benthacher/growth_module_pcb/3d/RNP0030B.stp

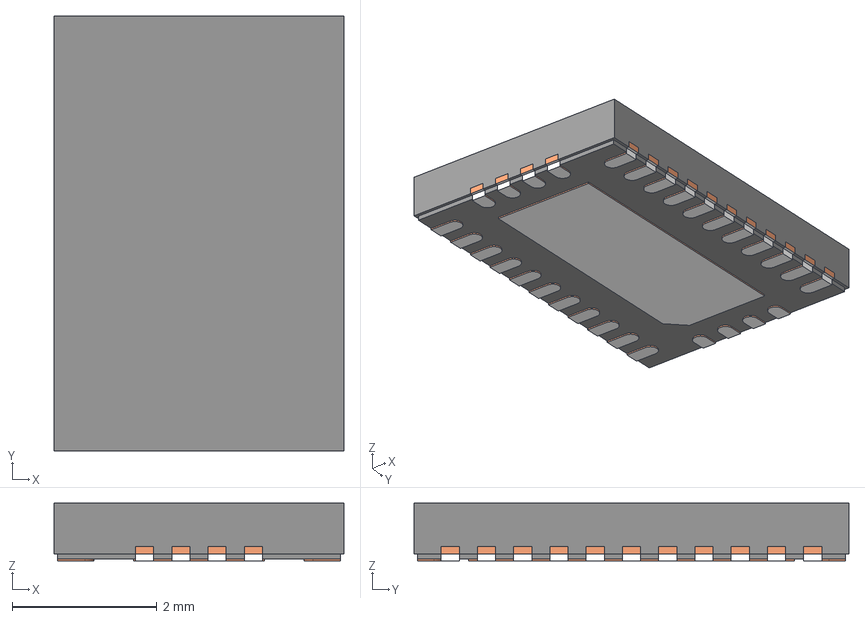
[picture p1: CAD file, 2024-05-28]
3d/RNP0030B.stp
4.00 x 6.00 x 0.8 mm
BODY-QFN_AF0
FRAME-RNP0030B_AF0
PIN1-ID
