benthacher/growth_module_pcb/growth_module_pcb.step

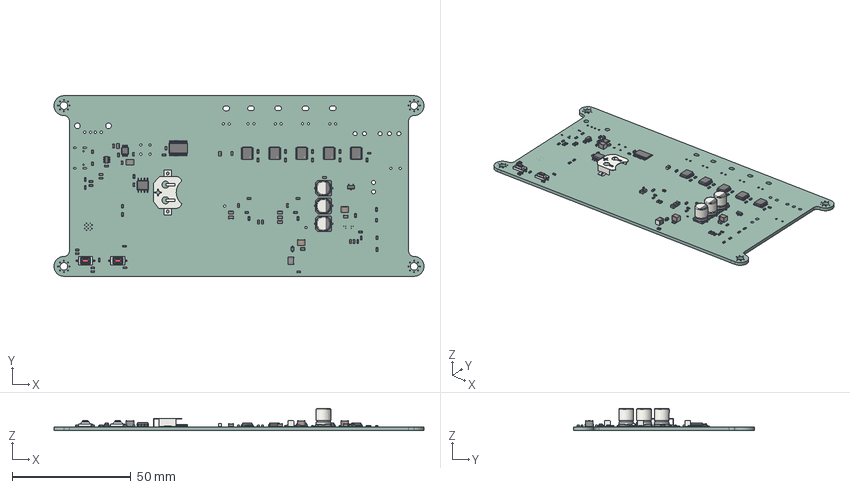
[picture p2: CAD file, 2024-05-28]
growth_module_pcb.step
156.1 x 76.2 x 9.35 mm
C_0603_1608Metric x 25
TSSOP_24_44x78mm_P065mm
C_0805_2012Metric x 8
R_0603_1608Metric x 34
L_1210_3225Metric x 2
TSSOP_16_1EP_44x5mm_Pitch065mm_EP34x5mm x 5
D_SOD_323
SOT_23_6
R_0805_2012Metric
C_1210_3225Metric x 2
CP_Elec_63x77 x 3
Keystone_3000_1x12mm
SW_SPST_CK_RS282G05A3 x 2
SOT_23
MSOP_10_3x3mm_P05mm
SOIC_8_39x49mm_P127mm
_autosave-growth_module_pcb_PCB
