benthacher/growth_module_pcb/3d/IND_BOURNS_SRP1270.step

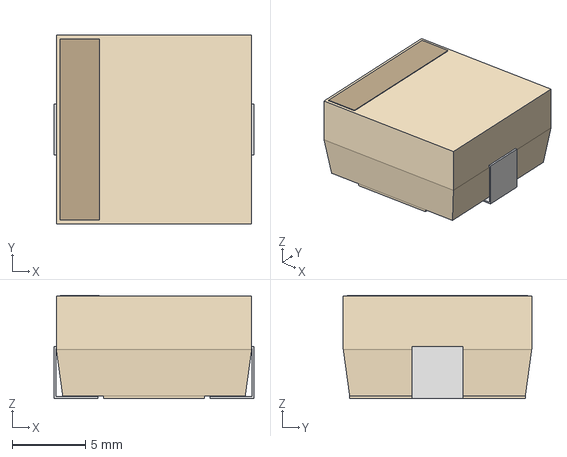
[picture p3: CAD file, 2024-05-28]
3d/IND_BOURNS_SRP1270.step
13.7 x 12.9 x 7.06 mm
