benthacher/growth_module_pcb/3d/TPS1HB50AQPWPRQ1.stp

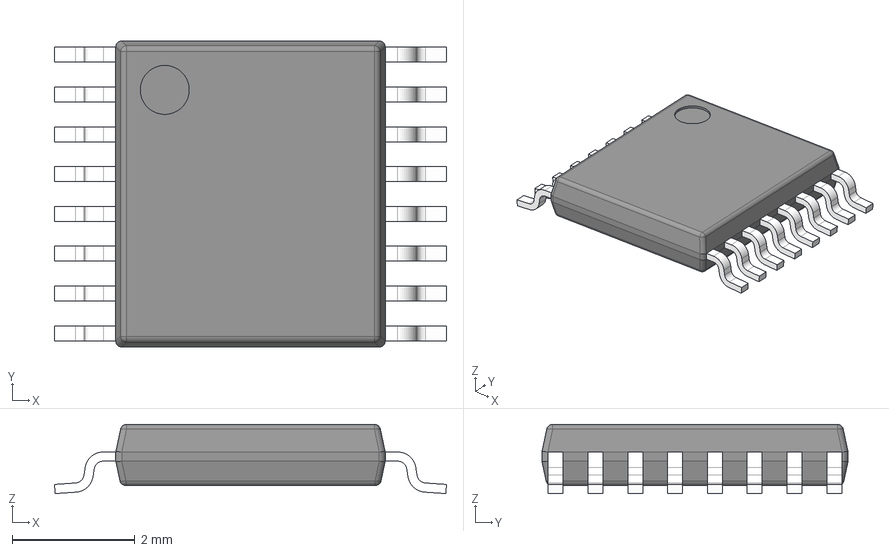
[picture p4: CAD file, 2024-05-28]
3d/TPS1HB50AQPWPRQ1.stp
6.40 x 5.00 x 1.13 mm
BODY-TSSOP
LEAD-TSSOP x 16
PIN1
DAP
