benthacher/growth_module_pcb/3d/SDR1006-220ML.stp

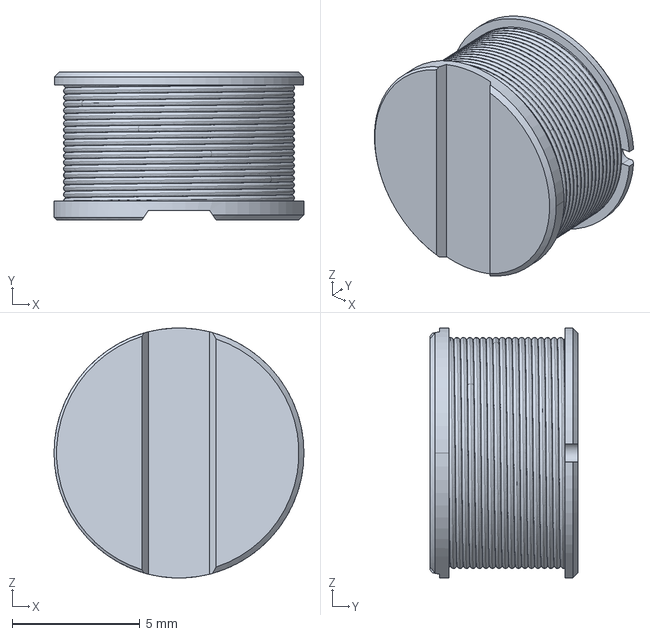
[picture p5: CAD file, 2024-05-28]
3d/SDR1006-220ML.stp
9.80 x 5.80 x 9.80 mm
