benthacher/growth_module_pcb/3d/ESP32-S3-WROOM-1-N8R8.step

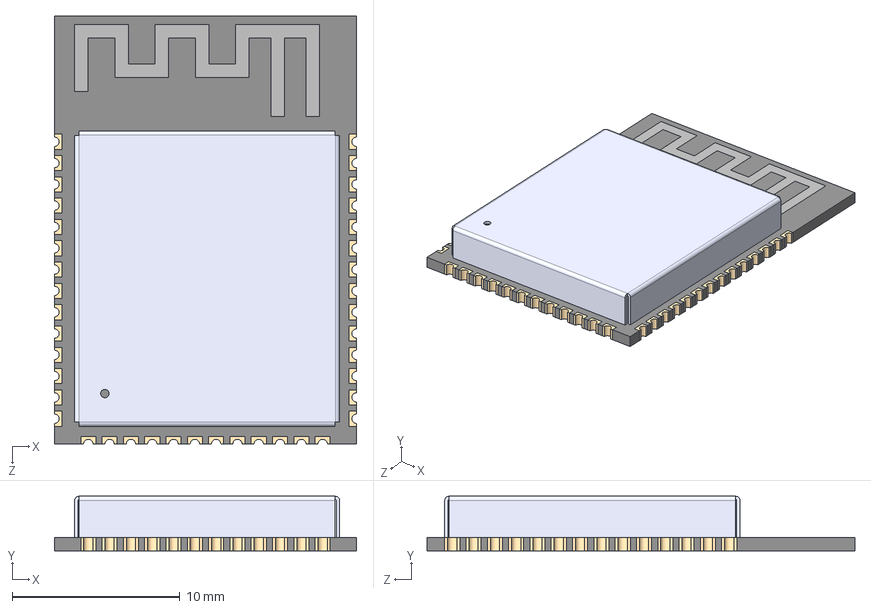
[picture p6: CAD file, 2024-05-28]
3d/ESP32-S3-WROOM-1-N8R8.step
18.0 x 3.25 x 25.5 mm
