benthacher/growth_module_pcb/3d/UE27AC54100.step

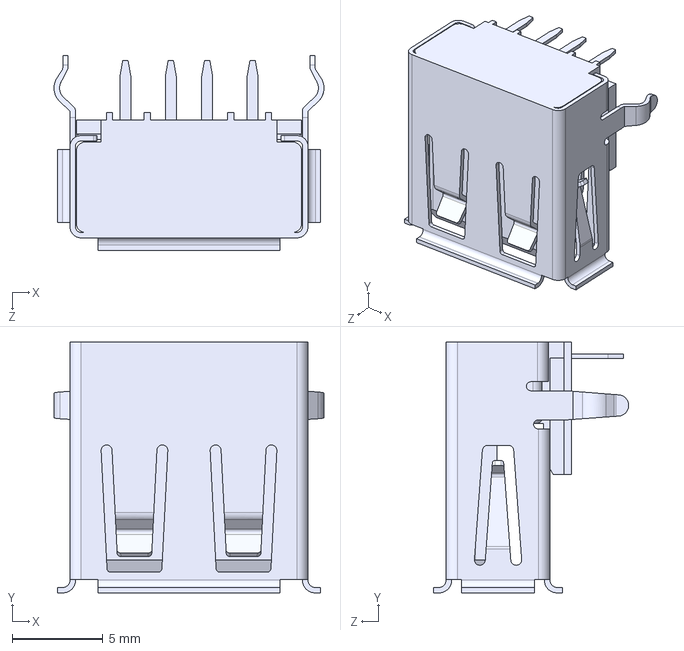
[picture p7: CAD file, 2024-05-28]
3d/UE27AC54100.step
14.9 x 13.8 x 10.7 mm
