benthacher/growth_module_pcb/3d/2-84952-0.stp

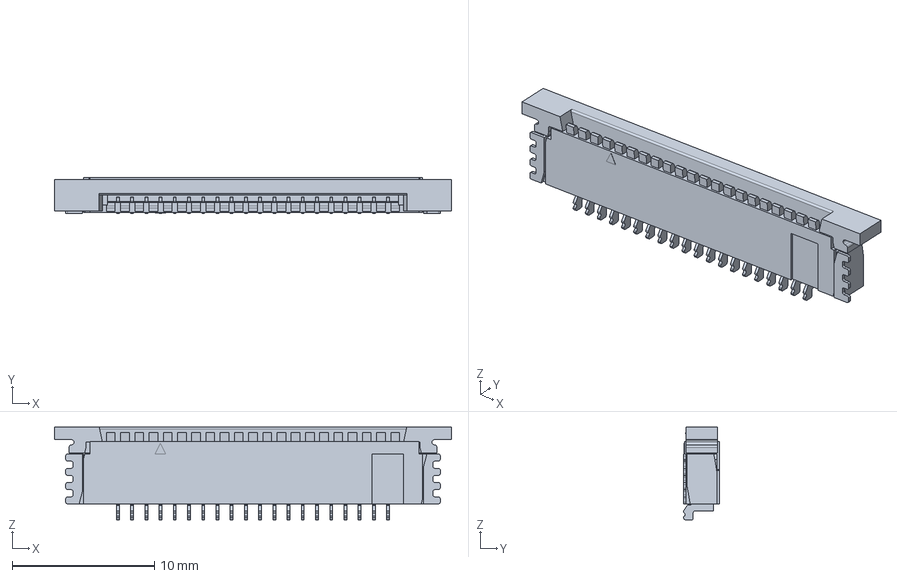
[picture p8: CAD file, 2024-05-28]
3d/2-84952-0.stp
27.9 x 2.56 x 6.54 mm
