benthacher/growth_module_pcb/3d/SFW16R-1STE1LF.step

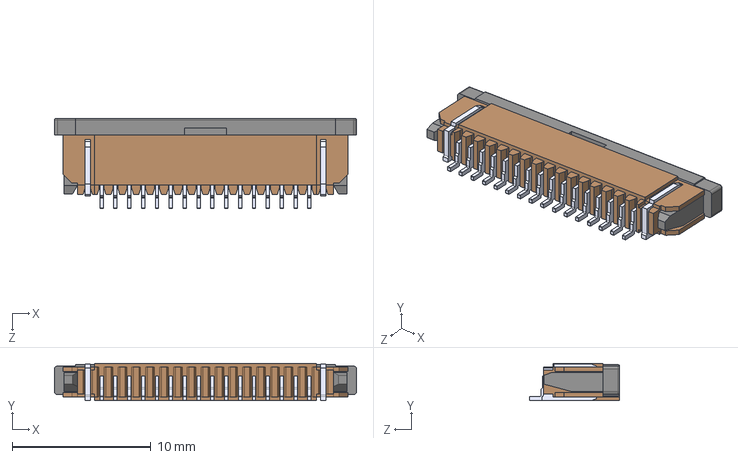
[picture p9: CAD file, 2024-05-28]
3d/SFW16R-1STE1LF.step
21.8 x 2.70 x 6.50 mm
