benthacher/growth_module_pcb/3d/TUSB1106RGTR.step

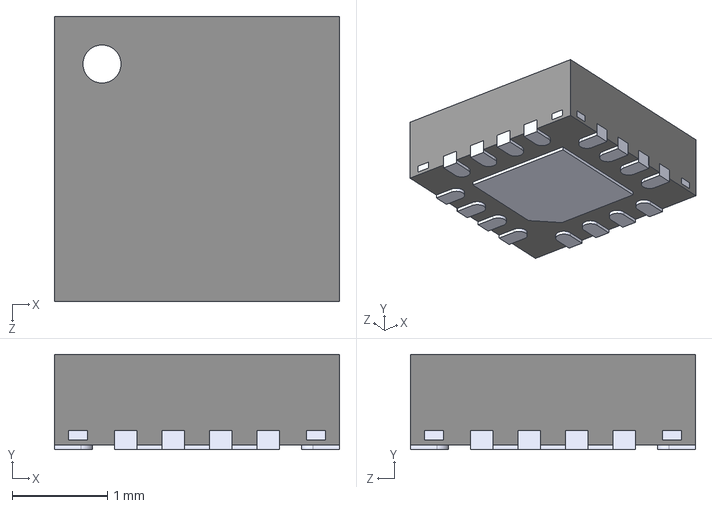
[picture p10: CAD file, 2024-05-28]
3d/TUSB1106RGTR.step
3.00 x 1.00 x 3.00 mm
