benthacher/growth_module_pcb/3d/DDA0008E.stp

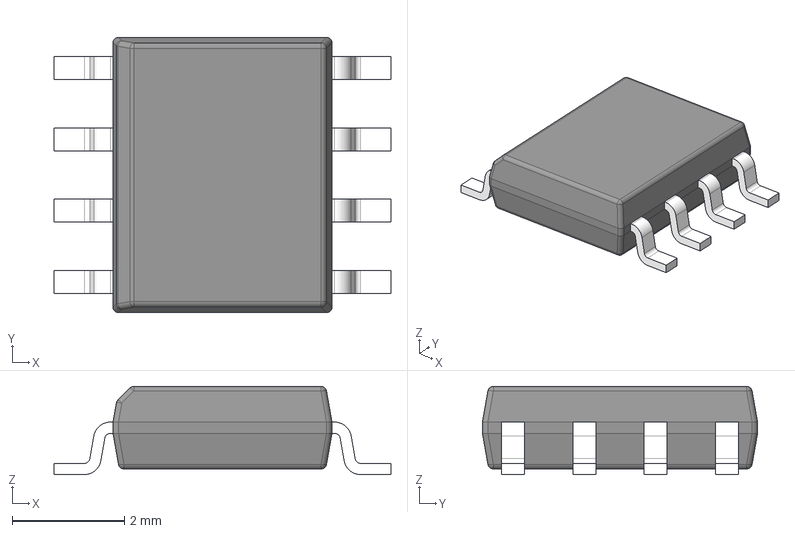
[picture p12: CAD file, 2024-05-28]
3d/DDA0008E.stp
6.00 x 4.90 x 1.57 mm
BODY-SO
LEAD-SO x 8
THERMALPAD-SO
