benthacher/growth_module_pcb/3d/INA200AIDR.step

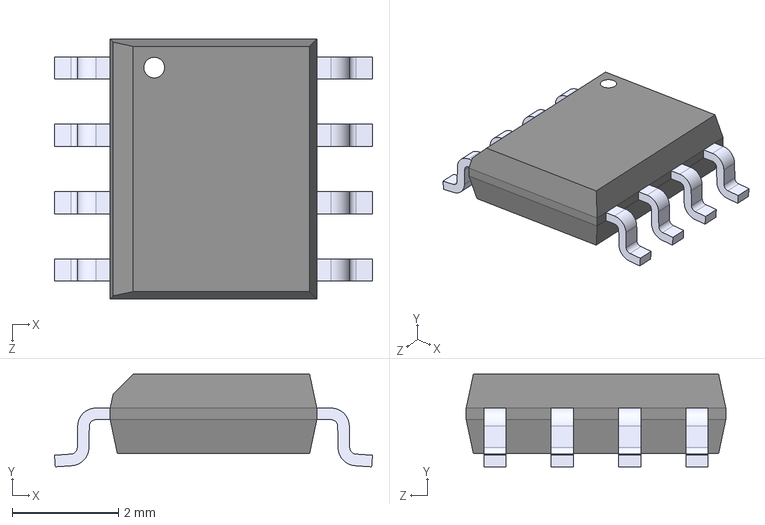
[picture p13: CAD file, 2024-05-28]
3d/INA200AIDR.step
6.00 x 1.75 x 4.90 mm
