benthacher/growth_module_pcb/3d/JST_-_S02B-XASS-1(LF)(SN).step

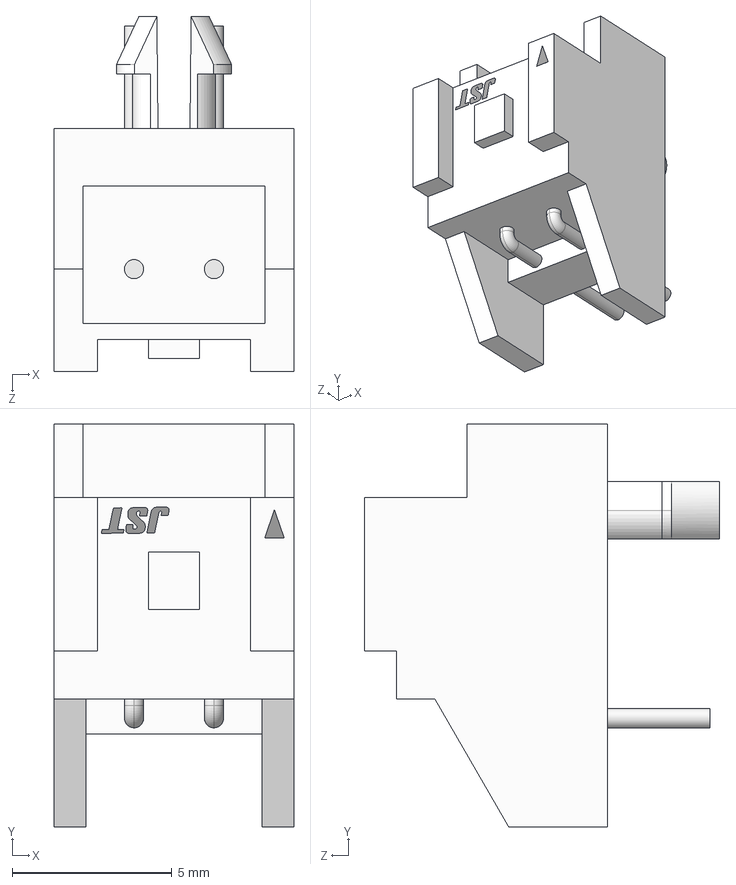
[picture p14: CAD file, 2024-05-28]
3d/JST_-_S02B-XASS-1(LF)(SN).step
7.50 x 12.6 x 11.1 mm
Pins
New Marking
JST Logo
