benthacher/growth_module_pcb/(list of files, cad)

Other CAD files:
3d/ESP32-S3-WROOM-2-N32R8V.step
