benthacher/growth_module_pcb/growth_module_pcb.kicad_pcb

## KiCad design growth_module_pcb.kicad_pcb (2024-05-28)

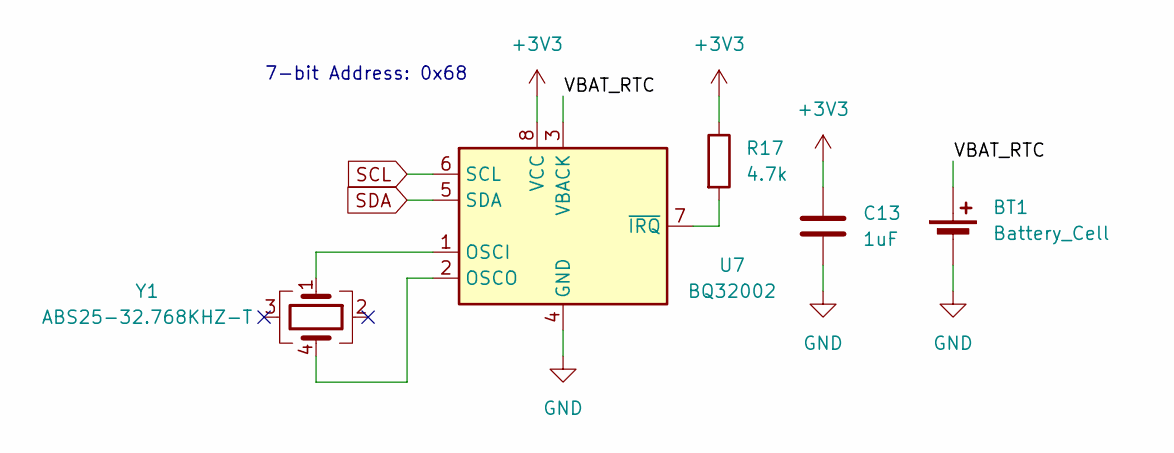
[picture p15: schematic rtc.kicad_sch]

Parts:
BT1: Battery_Cell; BatteryHolder_Keystone_3000_1x12mm
C13: 1uF; C_0603_1608Metric_Pad1.08x0.95mm_HandSolder
R17: 4.7k; R_0603_1608Metric_Pad0.98x0.95mm_HandSolder
U7: BQ32002; SOIC-8_3.9x4.9mm_P1.27mm
Y1: ABS25-32.768KHZ-T; Crystal_SMD_Abracon_ABS25-4Pin_8.0x3.8mm

Connections:
+3V3: C13.1, R17.1, U7.8 (VCC); also elsewhere on the board
/RTC/VBAT_RTC: BT1.1 (+), U7.3 (VBACK)
GND: BT1.2 (-), C13.2, U7.4 (GND); also elsewhere on the board
unnamed: U7.1 (OSCI), Y1.1
unnamed: U7.2 (OSCO), Y1.4
unnamed: R17.2, U7.7 (~IRQ)
SCL: U7.6 (SCL); also elsewhere on the board
SDA: U7.5 (SDA); also elsewhere on the board

Notes on the sheet:
7-bit Address: 0x68

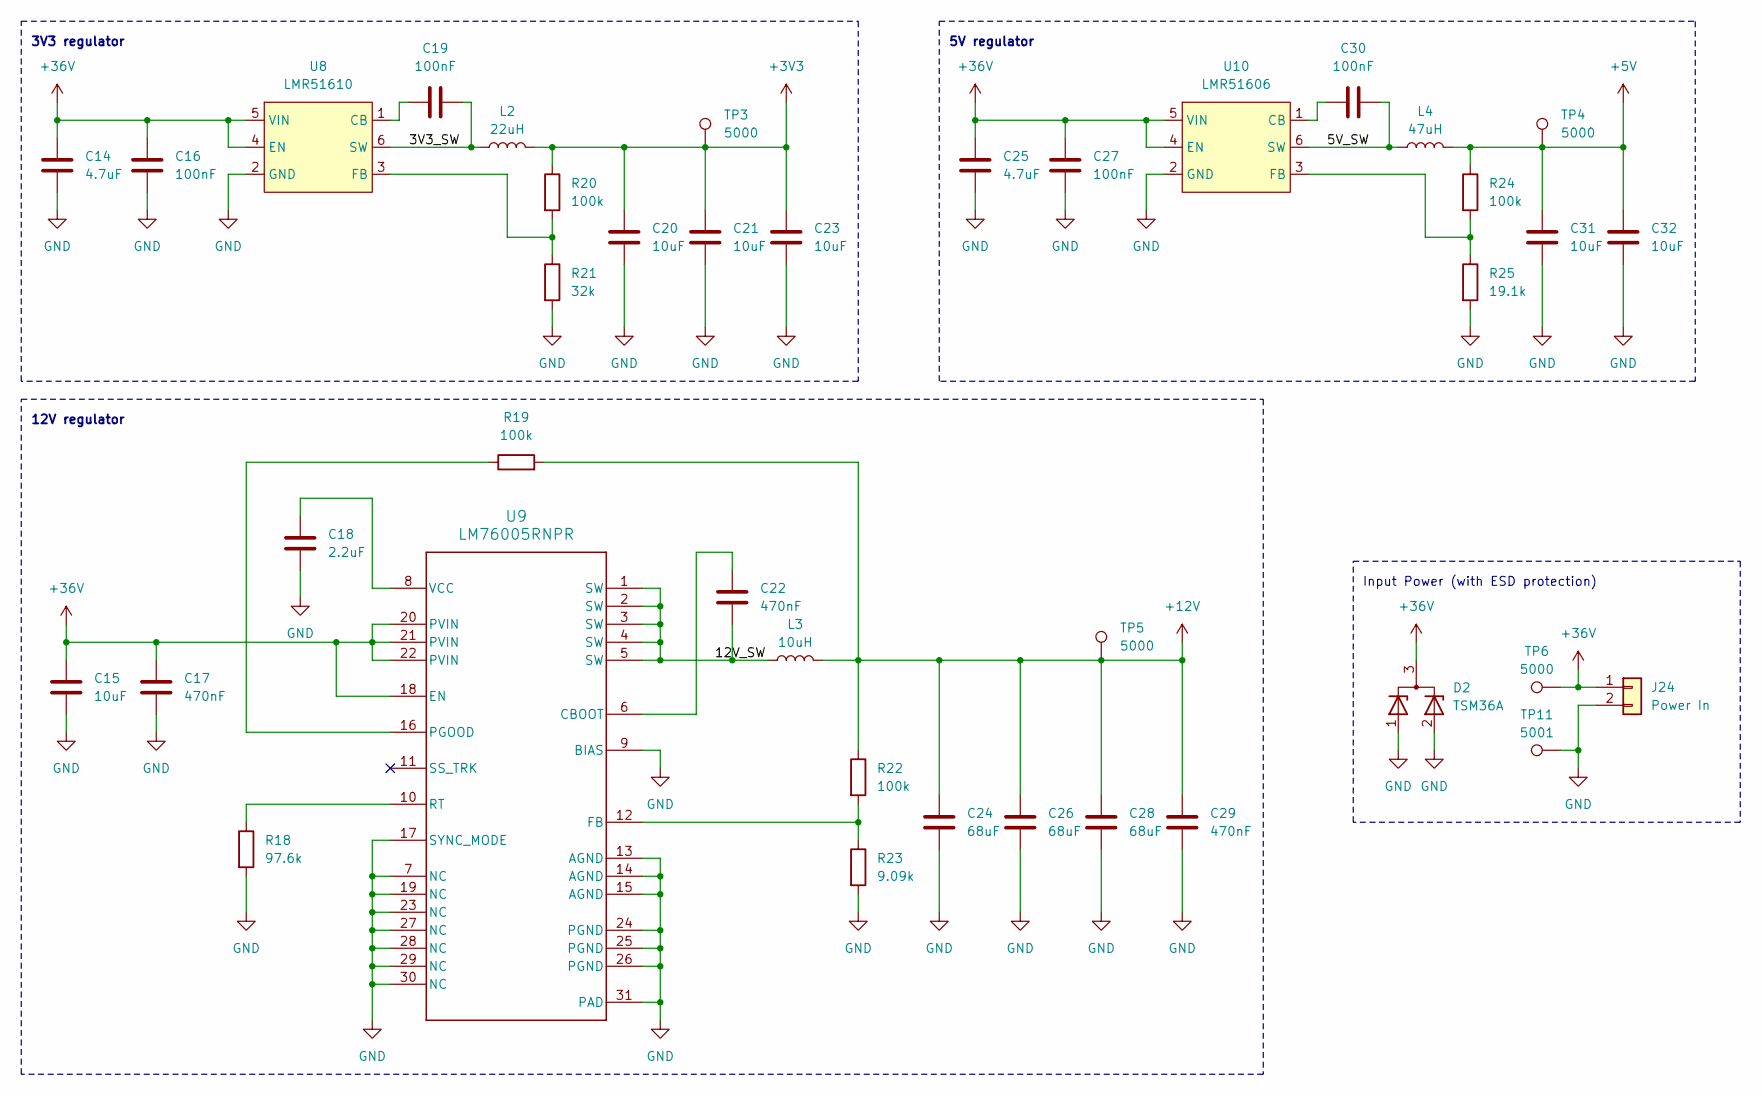
[picture p16: schematic power_electronics.kicad_sch]

Parts:
C14, C25: 4.7uF; C_2220_5750Metric_Pad1.97x5.40mm_HandSolder
C15: 10uF; C_1210_3225Metric_Pad1.33x2.70mm_HandSolder
C16, C19, C27, C30: 100nF; C_0603_1608Metric_Pad1.08x0.95mm_HandSolder
C17: 470nF; C_0805_2012Metric_Pad1.18x1.45mm_HandSolder
C18: 2.2uF; C_0603_1608Metric_Pad1.08x0.95mm_HandSolder
C20, C21, C23, C31, C32: 10uF; C_0805_2012Metric_Pad1.18x1.45mm_HandSolder
C22, C29: 470nF; C_0603_1608Metric_Pad1.08x0.95mm_HandSolder
C24, C26, C28: 68uF; CP_Elec_6.3x7.7
D2: TSM36A; SOT-23_Handsoldering
J24: Power In; JST_VH_S2P-VH_1x02_P3.96mm_Horizontal
L2: 22uH; SDR1006220ML
L3: 10uH; IND_BOURNS_SRP1270-M
L4: 47uH; SDR1006220ML
R18: 97.6k; R_0603_1608Metric_Pad0.98x0.95mm_HandSolder
R19, R20, R22, R24: 100k; R_0603_1608Metric_Pad0.98x0.95mm_HandSolder
R21: 32k; R_0603_1608Metric_Pad0.98x0.95mm_HandSolder
R23: 9.09k; R_0603_1608Metric_Pad0.98x0.95mm_HandSolder
R25: 19.1k; R_0603_1608Metric_Pad0.98x0.95mm_HandSolder
TP3, TP4, TP5, TP6: 5000; TestPoint_Keystone_5000-5004_Miniature
TP11: 5001; TestPoint_Keystone_5000-5004_Miniature
U8: LMR51610; LMR51610XDBVR
U9: LM76005RNPR; RNP0030A
U10: LMR51606; LMR51610XDBVR

Connections:
+3V3: C20.1, C21.1, C23.1, L2.2, R20.1, TP3.1; also elsewhere on the board
+5V: C31.1, C32.1, L4.2, R24.1, TP4.1; also elsewhere on the board
+12V: C24.1, C26.1, C28.1, C29.1, L3.2, R19.2, R22.1, TP5.1; also elsewhere on the board
+36V: C14.1, C15.1, C16.1, C17.1, C25.1, C27.1, D2.3 (A), J24.1, TP6.1, U8.4 (EN), U8.5 (VIN), U9.18 (EN), U9.20 (PVIN), U9.21 (PVIN), U9.22 (PVIN), U10.4 (EN), U10.5 (VIN); also elsewhere on the board
/Power electronics/3V3_SW: C19.2, L2.1, U8.6 (SW)
/Power electronics/5V_SW: C30.2, L4.1, U10.6 (SW)
/Power electronics/12V_SW: C22.2, L3.1, U9.1 (SW), U9.2 (SW), U9.3 (SW), U9.4 (SW), U9.5 (SW)
GND: C14.2, C15.2, C16.2, C17.2, C18.2, C20.2, C21.2, C23.2, C24.2, C25.2, C26.2, C27.2, C28.2, C29.2, C31.2, C32.2, D2.1 (K), D2.2 (K), J24.2, R18.2, R21.2, R23.2, R25.2, TP11.1, U8.2 (GND), U9.7 (NC), U9.9 (BIAS), U9.13 (AGND), U9.14 (AGND), U9.15 (AGND), U9.17 (SYNC_MODE), U9.19 (NC), U9.23 (NC), U9.24 (PGND), U9.25 (PGND), U9.26 (PGND), U9.27 (NC), U9.28 (NC), U9.29 (NC), U9.30 (NC), U9.31 (PAD), U10.2 (GND); also elsewhere on the board
unnamed: C19.1, U8.1 (CB)
unnamed: R20.2, R21.1, U8.3 (FB)
unnamed: C22.1, U9.6 (CBOOT)
unnamed: R22.2, R23.1, U9.12 (FB)
unnamed: R19.1, U9.16 (PGOOD)
unnamed: R18.1, U9.10 (RT)
unnamed: C18.1, U9.8 (VCC)
unnamed: C30.1, U10.1 (CB)
unnamed: R24.2, R25.1, U10.3 (FB)

Notes on the sheet:
Input Power (with ESD protection)
12V regulator
5V regulator
3V3 regulator

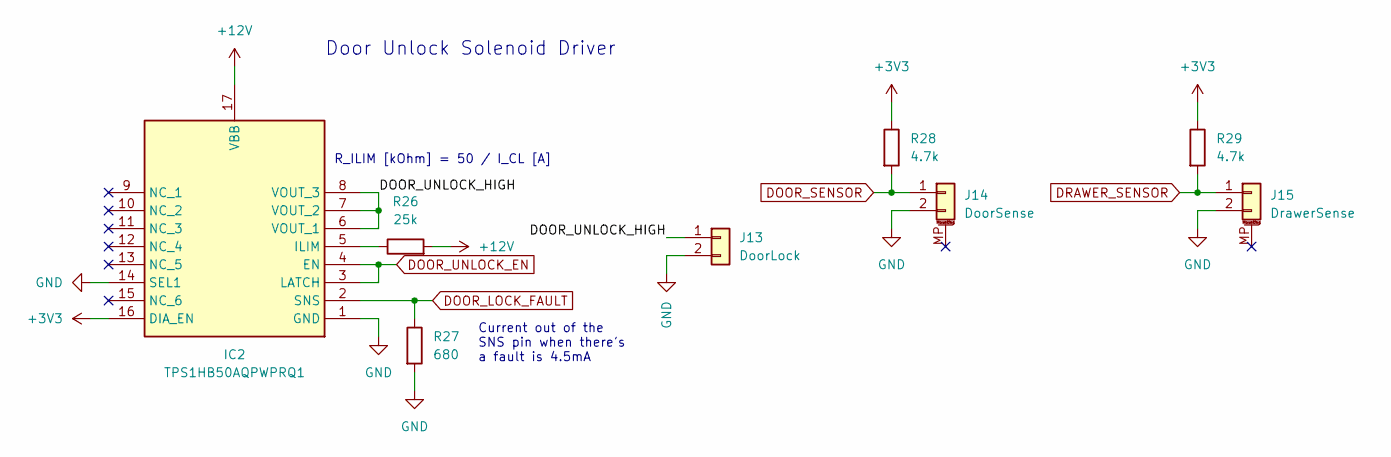
[picture p17: schematic door_and_drawer.kicad_sch]

Parts:
IC2: TPS1HB50AQPWPRQ1; HTSSOP-16-1EP_4.4x5mm_P0.65mm_EP3.4x5mm_Mask3x3mm_ThermalVi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; Manufacturer_Part_Number TPS1HB50AQPWPRQ1; Mouser Part Number 595-TPS1HB50AQPWPRQ1
J13: DoorLock; JST_XA_S02B-XASK-1_1x02_P2.50mm_Horizontal
J14: DoorSense; JST_SH_SM02B-SRSS-TB_1x02-1MP_P1.00mm_Horizontal
J15: DrawerSense; JST_SH_SM02B-SRSS-TB_1x02-1MP_P1.00mm_Horizontal
R26: 25k; R_0603_1608Metric_Pad0.98x0.95mm_HandSolder
R27: 680; R_0603_1608Metric_Pad0.98x0.95mm_HandSolder
R28, R29: 4.7k; R_0603_1608Metric_Pad0.98x0.95mm_HandSolder

Connections:
+3V3: IC2.16 (DIA_EN), R28.1, R29.1; also elsewhere on the board
+12V: IC2.17 (VBB), R26.2; also elsewhere on the board
/Door and Drawer/DOOR_UNLOCK_HIGH: IC2.6 (VOUT_1), IC2.7 (VOUT_2), IC2.8 (VOUT_3), J13.1
DOOR_LOCK_FAULT: IC2.2 (SNS), R27.1; also elsewhere on the board
DOOR_SENSOR: J14.1, R28.2; also elsewhere on the board
DOOR_UNLOCK_EN: IC2.3 (LATCH), IC2.4 (EN); also elsewhere on the board
DRAWER_SENSOR: J15.1, R29.2; also elsewhere on the board
GND: IC2.1 (GND), IC2.14 (SEL1), J13.2, J14.2, J15.2, R27.2; also elsewhere on the board
unnamed: IC2.5 (ILIM), R26.1

Notes on the sheet:
R_ILIM [kOhm] = 50 / I_CL [A]
Door Unlock Solenoid Driver
Current out of the SNS pin when there's a fault is 4.5mA

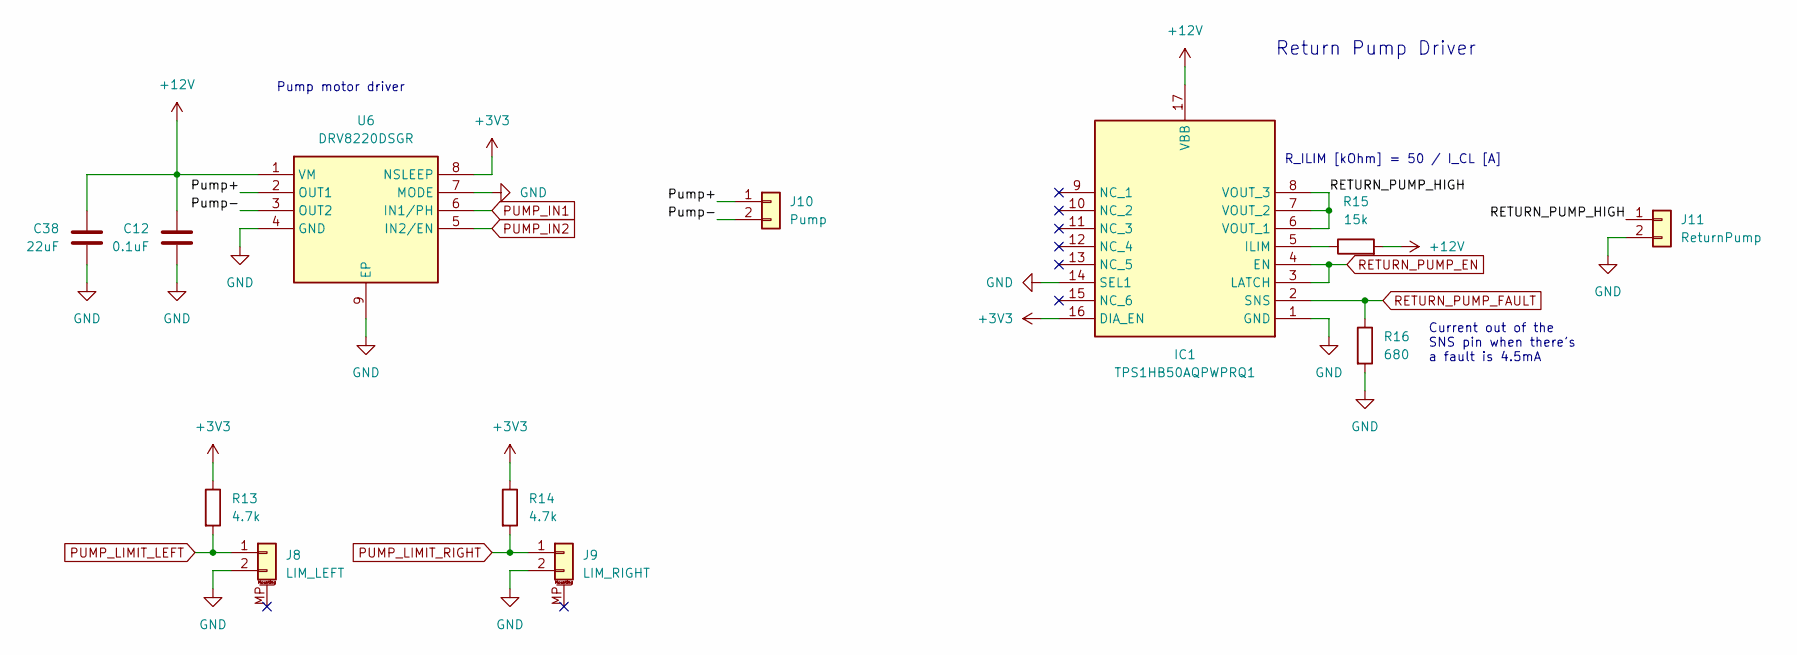
[picture p18: schematic pumps.kicad_sch]

Parts:
C12: 0.1uF; C_0603_1608Metric_Pad1.08x0.95mm_HandSolder
C38: 22uF; C_0805_2012Metric_Pad1.18x1.45mm_HandSolder
IC1: TPS1HB50AQPWPRQ1; HTSSOP-16-1EP_4.4x5mm_P0.65mm_EP3.4x5mm_Mask3x3mm_ThermalVi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; Manufacturer_Part_Number TPS1HB50AQPWPRQ1; Mouser Part Number 595-TPS1HB50AQPWPRQ1
J8: LIM_LEFT; JST_SH_SM02B-SRSS-TB_1x02-1MP_P1.00mm_Horizontal
J9: LIM_RIGHT; JST_SH_SM02B-SRSS-TB_1x02-1MP_P1.00mm_Horizontal
J10: Pump; JST_XA_S02B-XASK-1_1x02_P2.50mm_Horizontal
J11: ReturnPump; JST_XA_S02B-XASK-1_1x02_P2.50mm_Horizontal
R13, R14: 4.7k; R_0603_1608Metric_Pad0.98x0.95mm_HandSolder
R15: 15k; R_0603_1608Metric_Pad0.98x0.95mm_HandSolder
R16: 680; R_0603_1608Metric_Pad0.98x0.95mm_HandSolder
U6: DRV8220DSGR; SON50P200X200X80-9N; Manufacturer_Part_Number DRV8220DSGR; Mouser Part Number 595-DRV8220DSGR

Connections:
+3V3: IC1.16 (DIA_EN), R13.1, R14.1, U6.8 (NSLEEP); also elsewhere on the board
+12V: C12.1, C38.1, IC1.17 (VBB), R15.2, U6.1 (VM); also elsewhere on the board
/Pumps/Pump+: J10.1, U6.2 (OUT1)
/Pumps/Pump-: J10.2, U6.3 (OUT2)
/Pumps/RETURN_PUMP_HIGH: IC1.6 (VOUT_1), IC1.7 (VOUT_2), IC1.8 (VOUT_3), J11.1
GND: C12.2, C38.2, IC1.1 (GND), IC1.14 (SEL1), J8.2, J9.2, J11.2, R16.2, U6.4 (GND), U6.7 (MODE), U6.9 (EP); also elsewhere on the board
unnamed: IC1.5 (ILIM), R15.1
PUMP_IN1: U6.6 (IN1/PH); also elsewhere on the board
PUMP_IN2: U6.5 (IN2/EN); also elsewhere on the board
PUMP_LIMIT_LEFT: J8.1, R13.2; also elsewhere on the board
PUMP_LIMIT_RIGHT: J9.1, R14.2; also elsewhere on the board
RETURN_PUMP_EN: IC1.3 (LATCH), IC1.4 (EN); also elsewhere on the board
RETURN_PUMP_FAULT: IC1.2 (SNS), R16.1; also elsewhere on the board

Notes on the sheet:
R_ILIM [kOhm] = 50 / I_CL [A]
Current out of the SNS pin when there's a fault is 4.5mA
Return Pump Driver
Pump motor driver

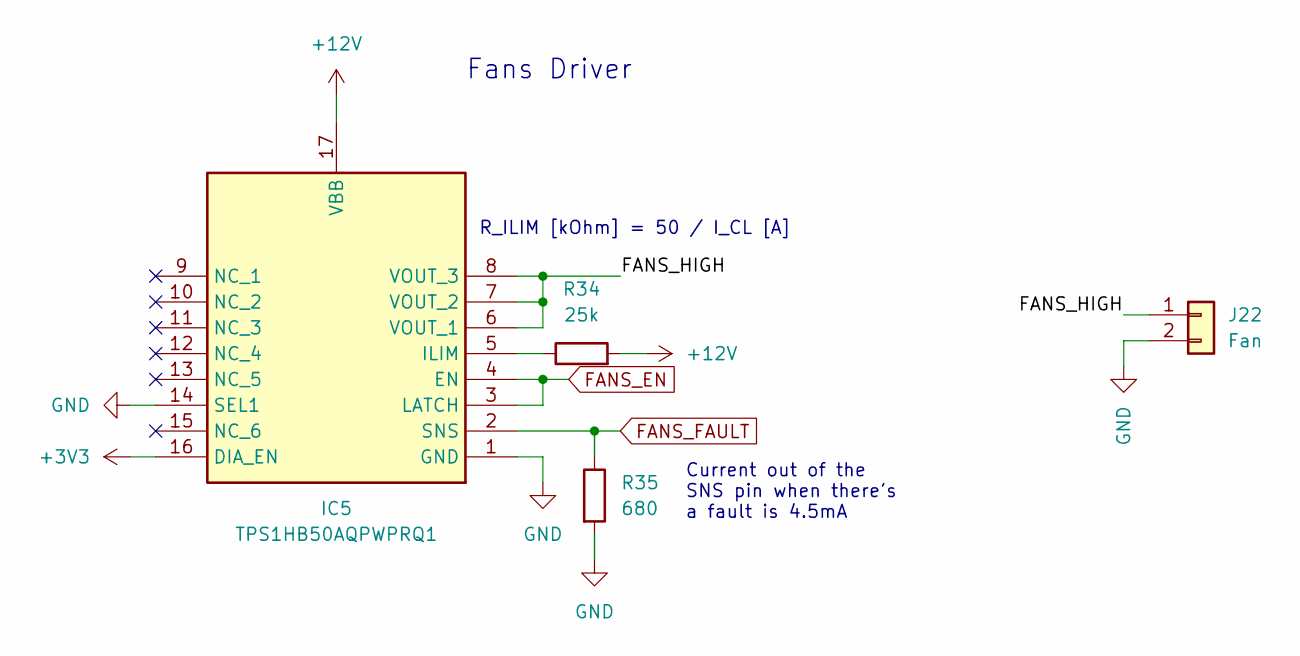
[picture p19: schematic fans.kicad_sch]

Parts:
IC5: TPS1HB50AQPWPRQ1; HTSSOP-16-1EP_4.4x5mm_P0.65mm_EP3.4x5mm_Mask3x3mm_ThermalVi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; Manufacturer_Part_Number TPS1HB50AQPWPRQ1; Mouser Part Number 595-TPS1HB50AQPWPRQ1
J22: Fan; JST_XA_S02B-XASK-1_1x02_P2.50mm_Horizontal
R34: 25k; R_0603_1608Metric_Pad0.98x0.95mm_HandSolder
R35: 680; R_0603_1608Metric_Pad0.98x0.95mm_HandSolder

Connections:
+3V3: IC5.16 (DIA_EN); also elsewhere on the board
+12V: IC5.17 (VBB), R34.2; also elsewhere on the board
/Fans/FANS_HIGH: IC5.6 (VOUT_1), IC5.7 (VOUT_2), IC5.8 (VOUT_3), J22.1
FANS_EN: IC5.3 (LATCH), IC5.4 (EN); also elsewhere on the board
FANS_FAULT: IC5.2 (SNS), R35.1; also elsewhere on the board
GND: IC5.1 (GND), IC5.14 (SEL1), J22.2, R35.2; also elsewhere on the board
unnamed: IC5.5 (ILIM), R34.1

Notes on the sheet:
R_ILIM [kOhm] = 50 / I_CL [A]
Current out of the SNS pin when there's a fault is 4.5mA
Fans Driver

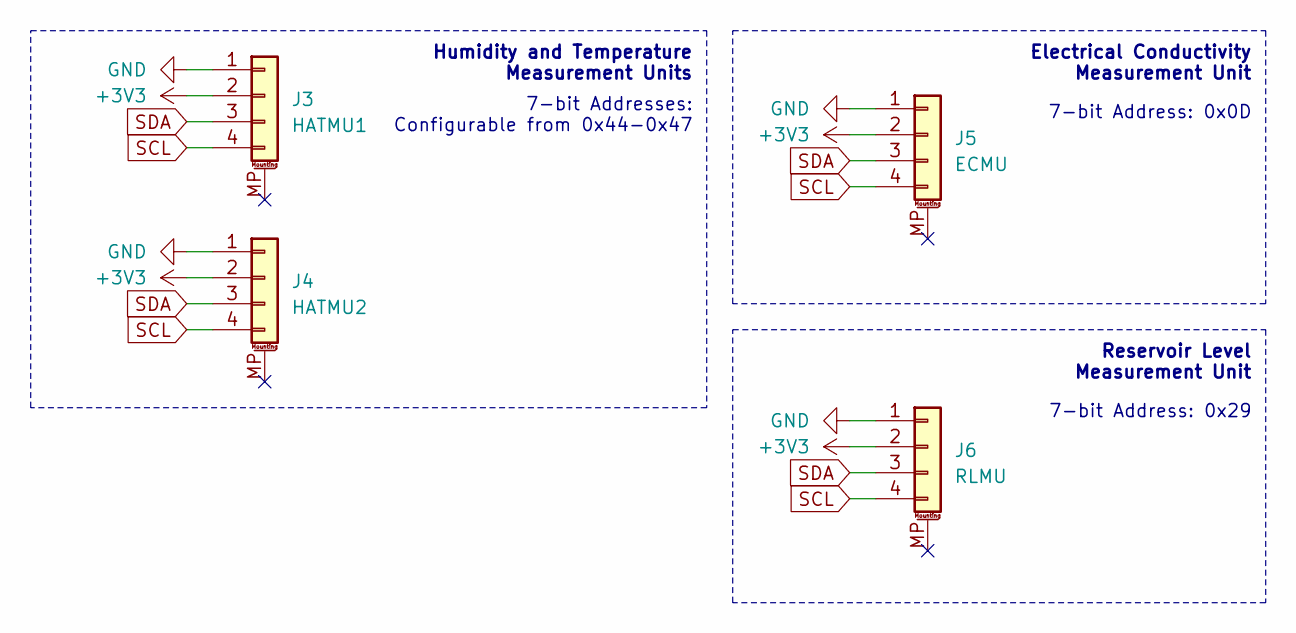
[picture p20: schematic external_sensors.kicad_sch]

Parts:
J3: HATMU1; JST_SH_SM04B-SRSS-TB_1x04-1MP_P1.00mm_Horizontal
J4: HATMU2; JST_SH_SM04B-SRSS-TB_1x04-1MP_P1.00mm_Horizontal
J5: ECMU; JST_SH_SM04B-SRSS-TB_1x04-1MP_P1.00mm_Horizontal
J6: RLMU; JST_SH_SM04B-SRSS-TB_1x04-1MP_P1.00mm_Horizontal

Connections:
+3V3: J3.2, J4.2, J5.2, J6.2; also elsewhere on the board
GND: J3.1, J4.1, J5.1, J6.1; also elsewhere on the board
SCL: J3.4, J4.4, J5.4, J6.4; also elsewhere on the board
SDA: J3.3, J4.3, J5.3, J6.3; also elsewhere on the board

Notes on the sheet:
Reservoir Level Measurement Unit
7-bit Addresses: Configurable from 0x44-0x47
Electrical Conductivity Measurement Unit
Humidity and Temperature Measurement Units
7-bit Address: 0x29
7-bit Address: 0x0D

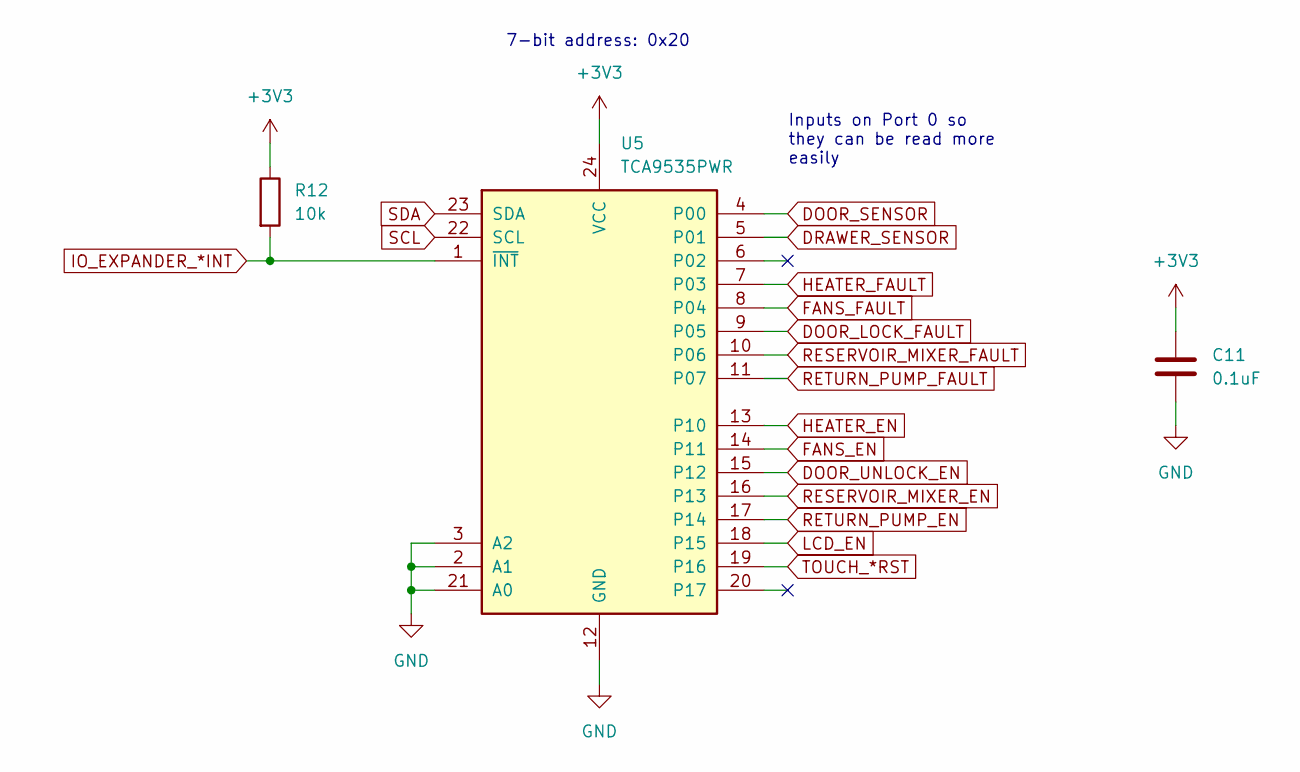
[picture p21: schematic io_expander.kicad_sch]

Parts:
C11: 0.1uF; C_0603_1608Metric_Pad1.08x0.95mm_HandSolder
R12: 10k; R_0603_1608Metric_Pad0.98x0.95mm_HandSolder
U5: TCA9535PWR; TSSOP-24_4.4x7.8mm_P0.65mm

Connections:
+3V3: C11.1, R12.1, U5.24 (VCC); also elsewhere on the board
DOOR_LOCK_FAULT: U5.9 (P05); also elsewhere on the board
DOOR_SENSOR: U5.4 (P00); also elsewhere on the board
DOOR_UNLOCK_EN: U5.15 (P12); also elsewhere on the board
DRAWER_SENSOR: U5.5 (P01); also elsewhere on the board
FANS_EN: U5.14 (P11); also elsewhere on the board
FANS_FAULT: U5.8 (P04); also elsewhere on the board
GND: C11.2, U5.2 (A1), U5.3 (A2), U5.12 (GND), U5.21 (A0); also elsewhere on the board
HEATER_EN: U5.13 (P10); also elsewhere on the board
HEATER_FAULT: U5.7 (P03); also elsewhere on the board
IO_EXPANDER_*INT: R12.2, U5.1 (~INT); also elsewhere on the board
LCD_EN: U5.18 (P15); also elsewhere on the board
RESERVOIR_MIXER_EN: U5.16 (P13); also elsewhere on the board
RESERVOIR_MIXER_FAULT: U5.10 (P06); also elsewhere on the board
RETURN_PUMP_EN: U5.17 (P14); also elsewhere on the board
RETURN_PUMP_FAULT: U5.11 (P07); also elsewhere on the board
SCL: U5.22 (SCL); also elsewhere on the board
SDA: U5.23 (SDA); also elsewhere on the board
TOUCH_*RST: U5.19 (P16); also elsewhere on the board

Notes on the sheet:
7-bit address: 0x20
Inputs on Port 0 so they can be read more easily

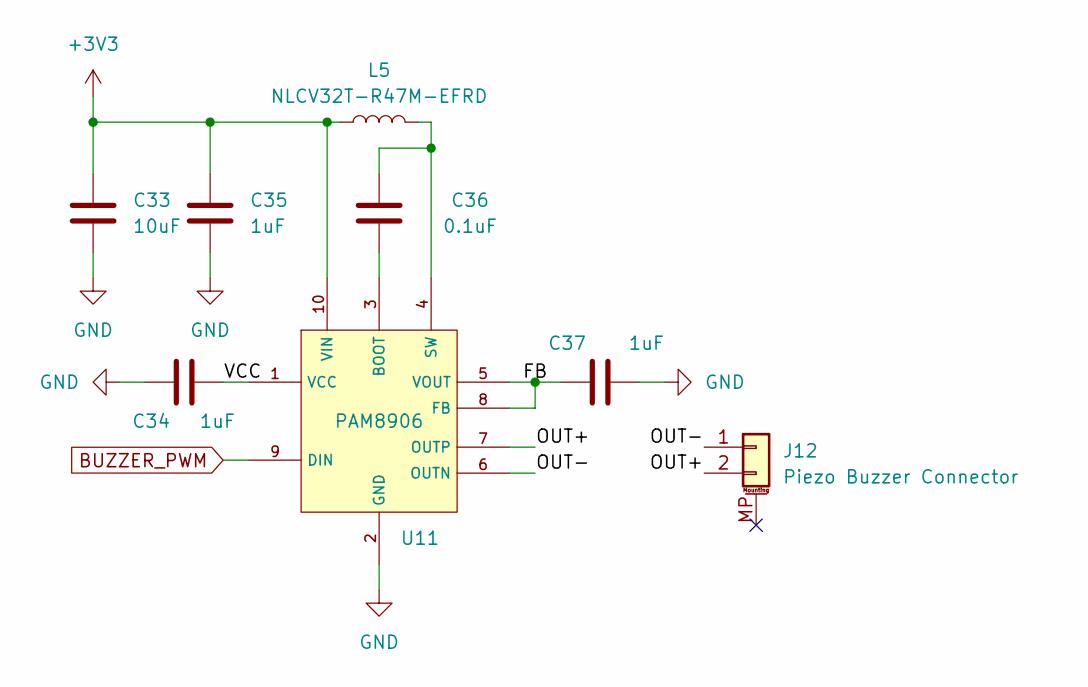
[picture p22: schematic piezo_buzzer.kicad_sch]

Parts:
C33: 10uF; C_0805_2012Metric_Pad1.18x1.45mm_HandSolder
C34, C35, C37: 1uF; C_0603_1608Metric_Pad1.08x0.95mm_HandSolder
C36: 0.1uF; C_0603_1608Metric_Pad1.08x0.95mm_HandSolder
J12: Piezo Buzzer Connector; JST_PH_S2B-PH-SM4-TB_1x02-1MP_P2.00mm_Horizontal
L5: NLCV32T-R47M-EFRD; L_1210_3225Metric_Pad1.42x2.65mm_HandSolder
U11: PAM8906; MSOP-10_3x3mm_P0.5mm

Connections:
+3V3: C33.2, C35.2, L5.1, U11.10 (VIN); also elsewhere on the board
/Piezo buzzer/FB: C37.1, U11.5 (VOUT), U11.8 (FB)
/Piezo buzzer/OUT+: J12.2, U11.7 (OUTP)
/Piezo buzzer/OUT-: J12.1, U11.6 (OUTN)
/Piezo buzzer/VCC: C34.2, U11.1 (VCC)
BUZZER_PWM: U11.9 (DIN); also elsewhere on the board
GND: C33.1, C34.1, C35.1, C37.2, U11.2 (GND); also elsewhere on the board
unnamed: C36.1, U11.3 (BOOT)
unnamed: C36.2, L5.2, U11.4 (SW)

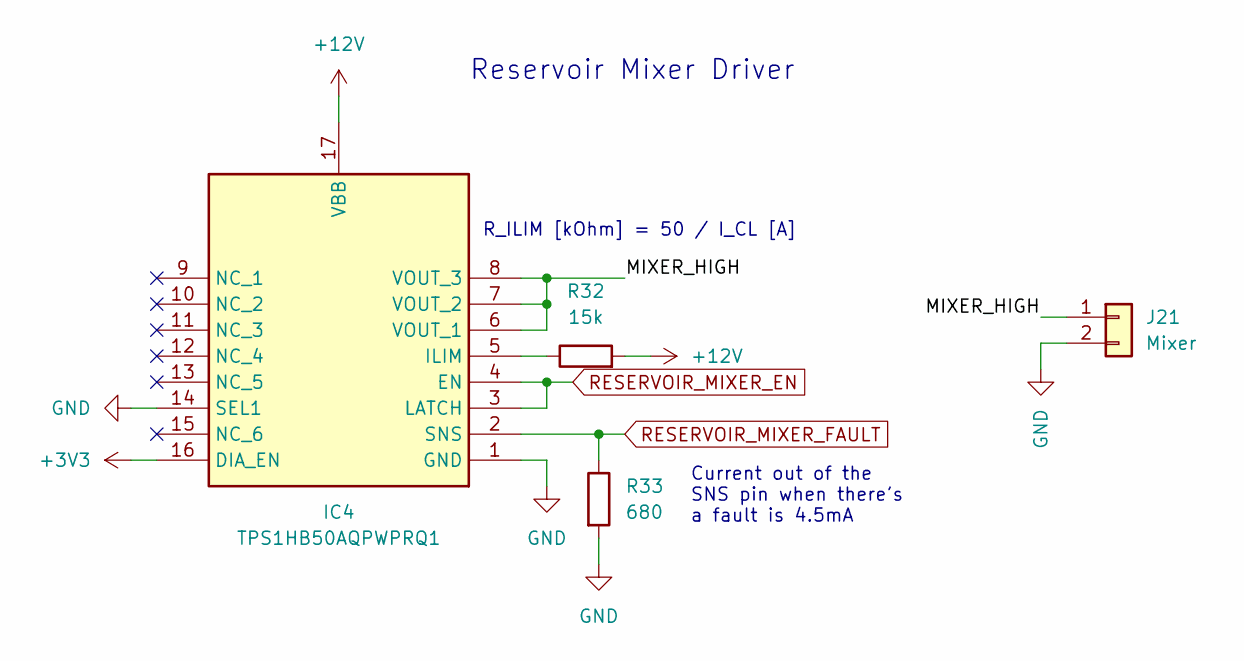
[picture p23: schematic reservoir_mixer.kicad_sch]

Parts:
IC4: TPS1HB50AQPWPRQ1; HTSSOP-16-1EP_4.4x5mm_P0.65mm_EP3.4x5mm_Mask3x3mm_ThermalVi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; Manufacturer_Part_Number TPS1HB50AQPWPRQ1; Mouser Part Number 595-TPS1HB50AQPWPRQ1
J21: Mixer; JST_XA_S02B-XASK-1_1x02_P2.50mm_Horizontal
R32: 15k; R_0603_1608Metric_Pad0.98x0.95mm_HandSolder
R33: 680; R_0603_1608Metric_Pad0.98x0.95mm_HandSolder

Connections:
+3V3: IC4.16 (DIA_EN); also elsewhere on the board
+12V: IC4.17 (VBB), R32.2; also elsewhere on the board
/Reservoir Mixer/MIXER_HIGH: IC4.6 (VOUT_1), IC4.7 (VOUT_2), IC4.8 (VOUT_3), J21.1
GND: IC4.1 (GND), IC4.14 (SEL1), J21.2, R33.2; also elsewhere on the board
unnamed: IC4.5 (ILIM), R32.1
RESERVOIR_MIXER_EN: IC4.3 (LATCH), IC4.4 (EN); also elsewhere on the board
RESERVOIR_MIXER_FAULT: IC4.2 (SNS), R33.1; also elsewhere on the board

Notes on the sheet:
R_ILIM [kOhm] = 50 / I_CL [A]
Reservoir Mixer Driver
Current out of the SNS pin when there's a fault is 4.5mA

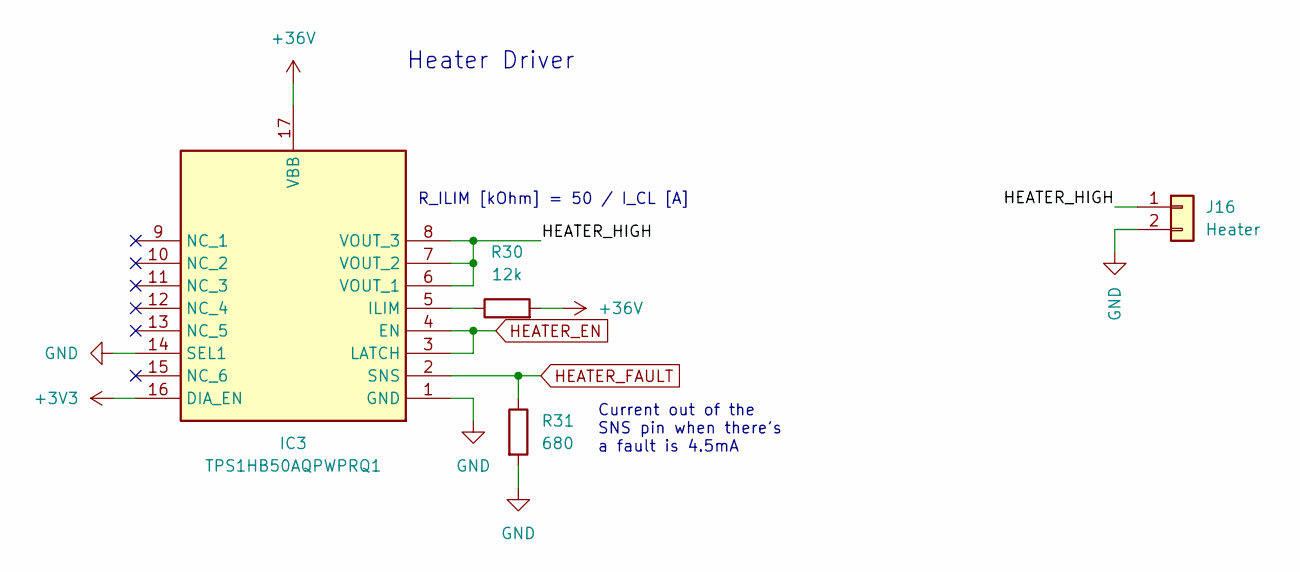
[picture p24: schematic heater.kicad_sch]

Parts:
IC3: TPS1HB50AQPWPRQ1; HTSSOP-16-1EP_4.4x5mm_P0.65mm_EP3.4x5mm_Mask3x3mm_ThermalVi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; Manufacturer_Part_Number TPS1HB50AQPWPRQ1; Mouser Part Number 595-TPS1HB50AQPWPRQ1
J16: Heater; JST_VH_S2P-VH_1x02_P3.96mm_Horizontal
R30: 12k; R_0603_1608Metric_Pad0.98x0.95mm_HandSolder
R31: 680; R_0603_1608Metric_Pad0.98x0.95mm_HandSolder

Connections:
+3V3: IC3.16 (DIA_EN); also elsewhere on the board
+36V: IC3.17 (VBB), R30.2; also elsewhere on the board
/Heater/HEATER_HIGH: IC3.6 (VOUT_1), IC3.7 (VOUT_2), IC3.8 (VOUT_3), J16.1
GND: IC3.1 (GND), IC3.14 (SEL1), J16.2, R31.2; also elsewhere on the board
HEATER_EN: IC3.3 (LATCH), IC3.4 (EN); also elsewhere on the board
HEATER_FAULT: IC3.2 (SNS), R31.1; also elsewhere on the board
unnamed: IC3.5 (ILIM), R30.1

Notes on the sheet:
Current out of the SNS pin when there's a fault is 4.5mA
Heater Driver
R_ILIM [kOhm] = 50 / I_CL [A]

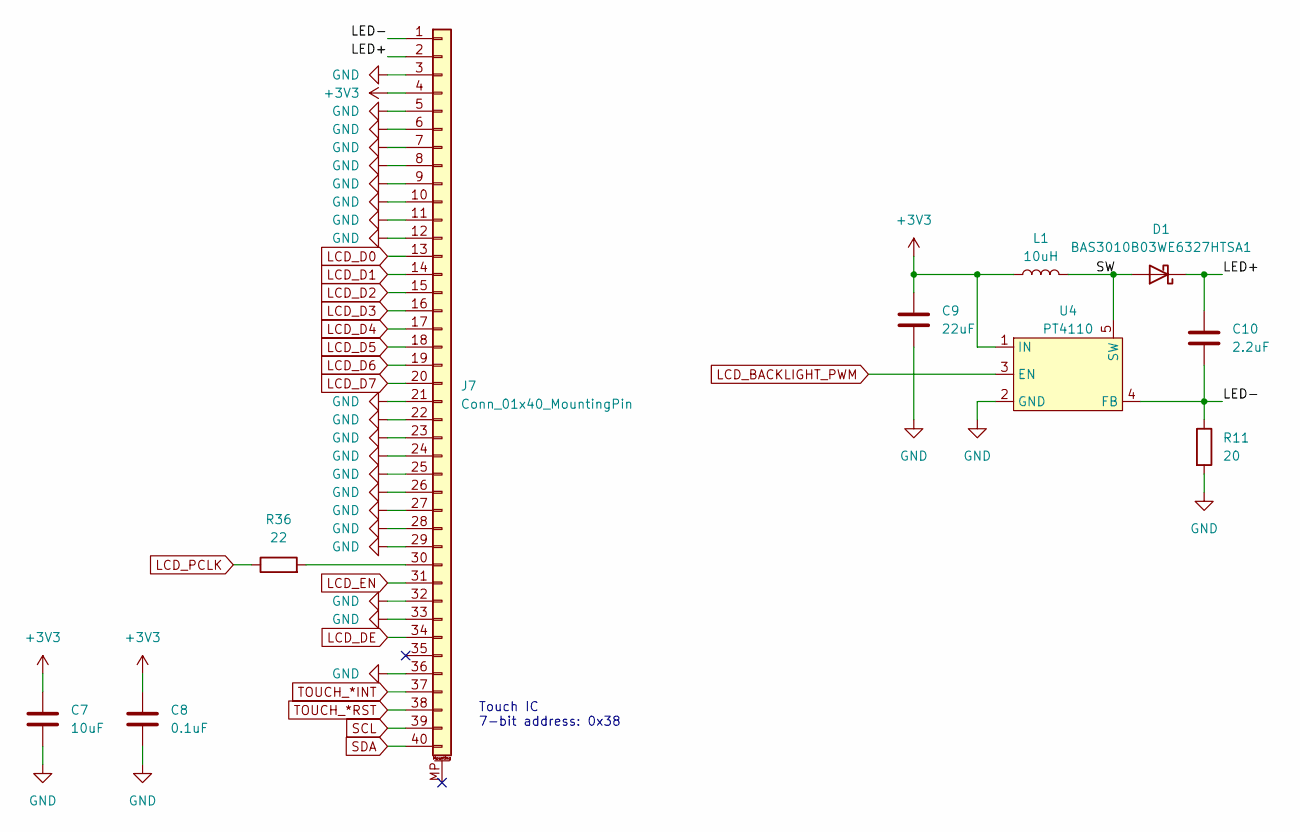
[picture p25: schematic touchscreen.kicad_sch]

Parts:
C7: 10uF; C_0603_1608Metric_Pad1.08x0.95mm_HandSolder
C8: 0.1uF; C_0603_1608Metric_Pad1.08x0.95mm_HandSolder
C9: 22uF; C_0603_1608Metric_Pad1.08x0.95mm_HandSolder
C10: 2.2uF; C_1210_3225Metric_Pad1.33x2.70mm_HandSolder
D1: BAS3010B03WE6327HTSA1; D_SOD-323_HandSoldering
J7: Conn_01x40_MountingPin; ER-CON40HT-1
L1: 10uH; L_1210_3225Metric_Pad1.42x2.65mm_HandSolder
R11: 20; R_0805_2012Metric_Pad1.20x1.40mm_HandSolder
R36: 22; R_0603_1608Metric_Pad0.98x0.95mm_HandSolder
U4: PT4110; SOT-89-5_Handsoldering

Connections:
+3V3: C7.1, C8.1, C9.1, J7.4, L1.1, U4.1 (IN); also elsewhere on the board
/Touchscreen/LED+: C10.1, D1.1 (K), J7.2
/Touchscreen/LED-: C10.2, J7.1, R11.1, U4.4 (FB)
/Touchscreen/SW: D1.2 (A), L1.2, U4.5 (SW)
GND: C7.2, C8.2, C9.2, J7.3, J7.5, J7.6, J7.7, J7.8, J7.9, J7.10, J7.11, J7.12, J7.21, J7.22, J7.23, J7.24, J7.25, J7.26, J7.27, J7.28, J7.29, J7.32, J7.33, J7.36, R11.2, U4.2 (GND); also elsewhere on the board
LCD_BACKLIGHT_PWM: U4.3 (EN); also elsewhere on the board
LCD_D0: J7.13; also elsewhere on the board
LCD_D1: J7.14; also elsewhere on the board
LCD_D2: J7.15; also elsewhere on the board
LCD_D3: J7.16; also elsewhere on the board
LCD_D4: J7.17; also elsewhere on the board
LCD_D5: J7.18; also elsewhere on the board
LCD_D6: J7.19; also elsewhere on the board
LCD_D7: J7.20; also elsewhere on the board
LCD_DE: J7.34; also elsewhere on the board
LCD_EN: J7.31; also elsewhere on the board
LCD_PCLK: R36.1; also elsewhere on the board
unnamed: J7.30, R36.2
SCL: J7.39; also elsewhere on the board
SDA: J7.40; also elsewhere on the board
TOUCH_*INT: J7.37; also elsewhere on the board
TOUCH_*RST: J7.38; also elsewhere on the board

Notes on the sheet:
Touch IC 7-bit address: 0x38

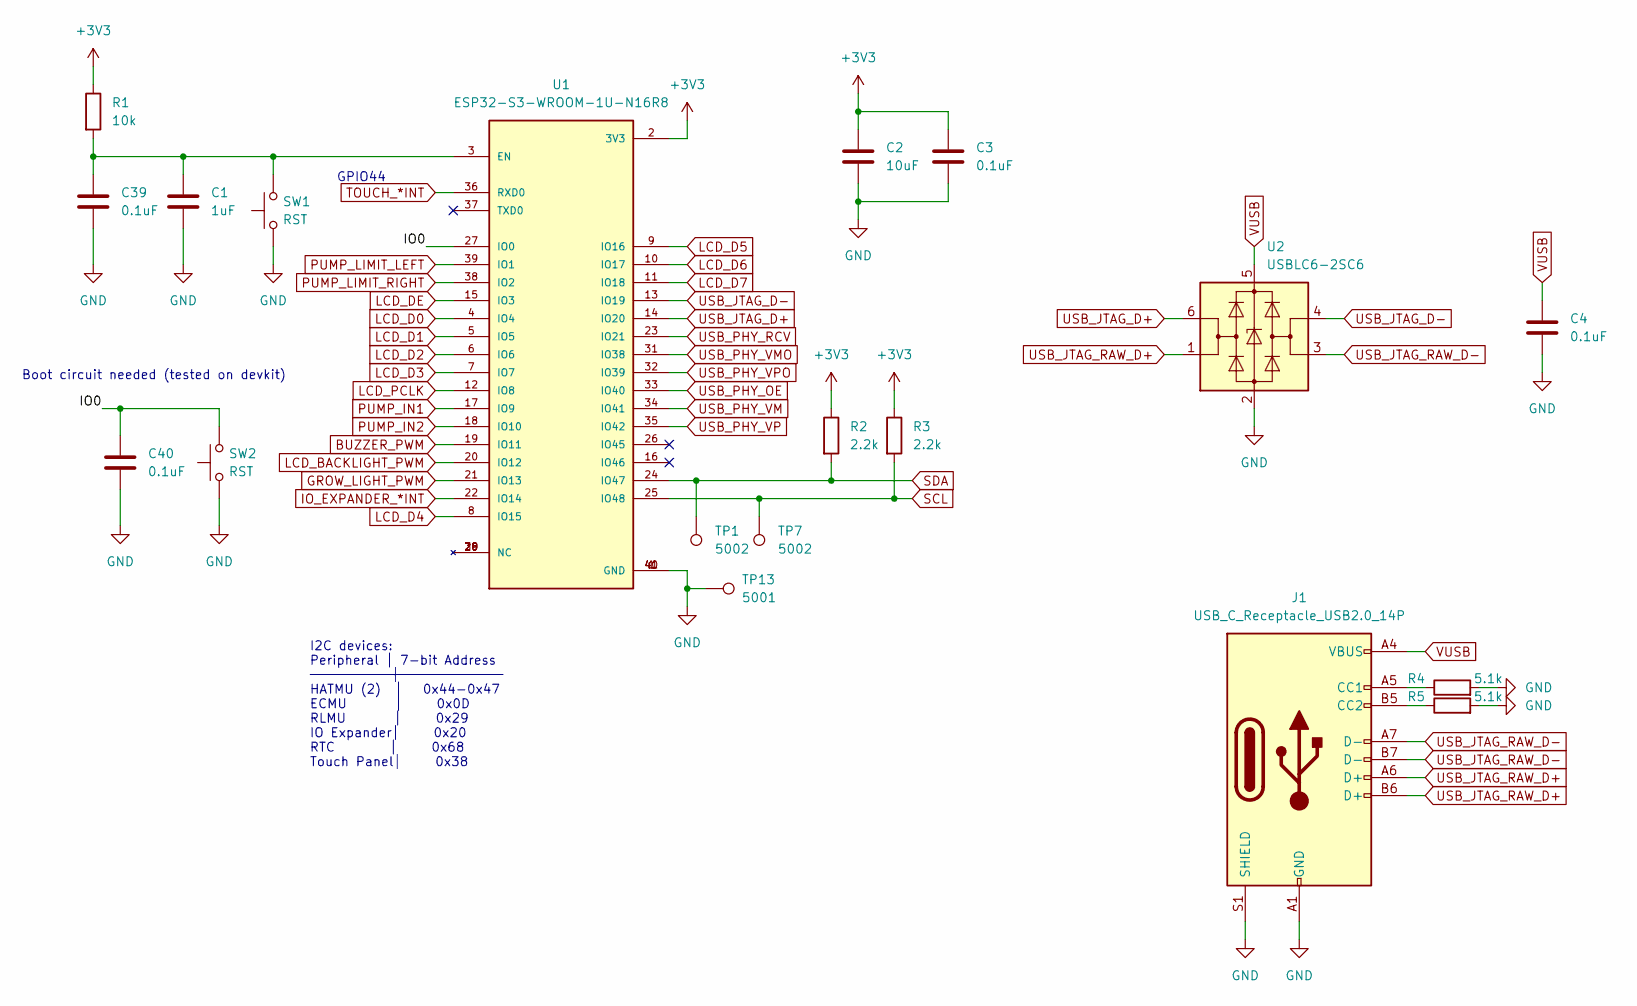
[picture p26: schematic mcu.kicad_sch]

Parts:
C1: 1uF; C_0603_1608Metric_Pad1.08x0.95mm_HandSolder
C2: 10uF; C_0603_1608Metric_Pad1.08x0.95mm_HandSolder
C3, C4, C39, C40: 0.1uF; C_0603_1608Metric_Pad1.08x0.95mm_HandSolder
J1: USB_C_Receptacle_USB2.0_14P; USB_C_Receptacle_HRO_TYPE-C-31-M-12
R1: 10k; R_0603_1608Metric_Pad0.98x0.95mm_HandSolder
R2, R3: 2.2k; R_0603_1608Metric_Pad0.98x0.95mm_HandSolder
R4, R5: 5.1k; R_0603_1608Metric_Pad0.98x0.95mm_HandSolder
SW1, SW2: RST; SW_SPST_CK_RS282G05A3
TP1, TP7: 5002; TestPoint_Keystone_5000-5004_Miniature
TP13: 5001; TestPoint_Keystone_5000-5004_Miniature
U1: ESP32-S3-WROOM-1U-N16R8; XCVR_ESP32-S3-WROOM-2-N32R8V; PARTREV 1.0
U2: USBLC6-2SC6; SOT-23-6

Connections:
+3V3: C2.1, C3.1, R1.1, R2.1, R3.1, U1.2 (3V3); also elsewhere on the board
/MCU/IO0: C40.1, SW2.2, U1.27 (IO0)
BUZZER_PWM: U1.19 (IO11); also elsewhere on the board
GND: C1.2, C2.2, C3.2, C4.2, C39.2, C40.2, J1.A1 (GND), J1.A12 (GND), J1.B1 (GND), J1.B12 (GND), J1.S1 (SHIELD), R4.2, R5.2, SW1.1, SW2.1, TP13.1, U1.1 (GND), U1.40 (GND), U1.41 (GND), U2.2 (GND); also elsewhere on the board
GROW_LIGHT_PWM: U1.21 (IO13); also elsewhere on the board
IO_EXPANDER_*INT: U1.22 (IO14); also elsewhere on the board
LCD_BACKLIGHT_PWM: U1.20 (IO12); also elsewhere on the board
LCD_D0: U1.4 (IO4); also elsewhere on the board
LCD_D1: U1.5 (IO5); also elsewhere on the board
LCD_D2: U1.6 (IO6); also elsewhere on the board
LCD_D3: U1.7 (IO7); also elsewhere on the board
LCD_D4: U1.8 (IO15); also elsewhere on the board
LCD_D5: U1.9 (IO16); also elsewhere on the board
LCD_D6: U1.10 (IO17); also elsewhere on the board
LCD_D7: U1.11 (IO18); also elsewhere on the board
LCD_DE: U1.15 (IO3); also elsewhere on the board
LCD_PCLK: U1.12 (IO8); also elsewhere on the board
unnamed: J1.A5 (CC1), R4.1
unnamed: J1.B5 (CC2), R5.1
unnamed: C1.1, C39.1, R1.2, SW1.2, U1.3 (EN)
PUMP_IN1: U1.17 (IO9); also elsewhere on the board
PUMP_IN2: U1.18 (IO10); also elsewhere on the board
PUMP_LIMIT_LEFT: U1.39 (IO1); also elsewhere on the board
PUMP_LIMIT_RIGHT: U1.38 (IO2); also elsewhere on the board
SCL: R3.2, TP7.1, U1.25 (IO48); also elsewhere on the board
SDA: R2.2, TP1.1, U1.24 (IO47); also elsewhere on the board
TOUCH_*INT: U1.36 (RXD0); also elsewhere on the board
USB_JTAG_D+: U1.14 (IO20), U2.6 (I/O1)
USB_JTAG_D-: U1.13 (IO19), U2.4 (I/O2)
USB_JTAG_RAW_D+: J1.A6 (D+), J1.B6 (D+), U2.1 (I/O1)
USB_JTAG_RAW_D-: J1.A7 (D-), J1.B7 (D-), U2.3 (I/O2)
USB_PHY_OE: U1.33 (IO40); also elsewhere on the board
USB_PHY_RCV: U1.23 (IO21); also elsewhere on the board
USB_PHY_VM: U1.34 (IO41); also elsewhere on the board
USB_PHY_VMO: U1.31 (IO38); also elsewhere on the board
USB_PHY_VP: U1.35 (IO42); also elsewhere on the board
USB_PHY_VPO: U1.32 (IO39); also elsewhere on the board
VUSB: C4.1, J1.A4 (VBUS), J1.A9 (VBUS), J1.B4 (VBUS), J1.B9 (VBUS), U2.5 (VBUS)

Notes on the sheet:
I2C devices: Peripheral │ 7-bit Address ───────────┼────────────── HATMU (2) │ 0x44-0x47 ECMU │ 0x0D RLMU │ 0x29 IO Expander│ 0x20 RTC │ 0x68 Touch Panel│ 0x38
GPIO44
Boot circuit needed (tested on devkit)
