benthacher/growth_module_pcb/growth_module_pcb.kicad_pcb

## KiCad design growth_module_pcb.kicad_pcb (continued)

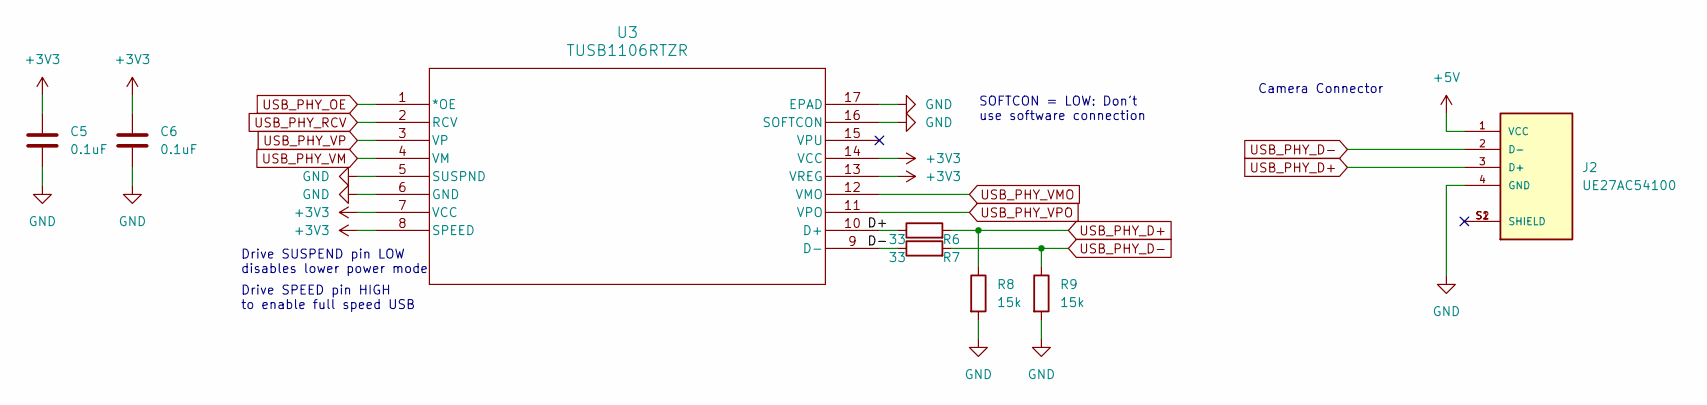
[picture p27: schematic usb_camera.kicad_sch]

Parts:
C5, C6: 0.1uF; C_0603_1608Metric_Pad1.08x0.95mm_HandSolder
J2: UE27AC54100; AMPHENOL_UE27AC54100; PARTREV E
R6, R7: 33; R_0603_1608Metric_Pad0.98x0.95mm_HandSolder
R8, R9: 15k; R_0603_1608Metric_Pad0.98x0.95mm_HandSolder
U3: TUSB1106RTZR; Texas_Instruments-TUSB1106RTZR-Manufacturer_Recommended

Connections:
+3V3: C5.1, C6.1, U3.7 (VCC), U3.8 (SPEED), U3.13 (VREG), U3.14 (VCC); also elsewhere on the board
+5V: J2.1 (VCC); also elsewhere on the board
/USB Camera/D+: R6.1, U3.10 (D+)
/USB Camera/D-: R7.1, U3.9 (D-)
GND: C5.2, C6.2, J2.4 (GND), R8.2, R9.2, U3.5 (SUSPND), U3.6 (GND), U3.16 (SOFTCON), U3.17 (EPAD); also elsewhere on the board
USB_PHY_D+: J2.3 (D+), R6.2, R8.1
USB_PHY_D-: J2.2 (D-), R7.2, R9.1
USB_PHY_OE: U3.1 (*OE); also elsewhere on the board
USB_PHY_RCV: U3.2 (RCV); also elsewhere on the board
USB_PHY_VM: U3.4 (VM); also elsewhere on the board
USB_PHY_VMO: U3.12 (VMO); also elsewhere on the board
USB_PHY_VP: U3.3 (VP); also elsewhere on the board
USB_PHY_VPO: U3.11 (VPO); also elsewhere on the board

Notes on the sheet:
Drive SPEED pin HIGH to enable full speed USB
Drive SUSPEND pin LOW disables lower power mode
Camera Connector
SOFTCON = LOW: Don't use software connection

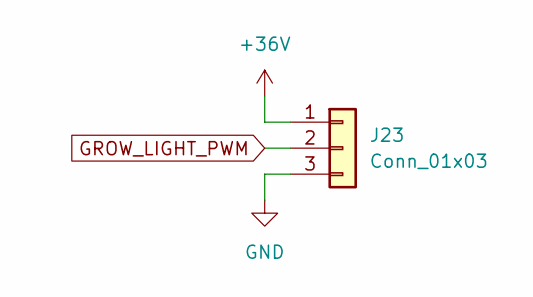
[picture p28: schematic grow_lights.kicad_sch]

Parts:
J23: Conn_01x03; JST_VH_S3P-VH_1x03_P3.96mm_Horizontal

Connections:
+36V: J23.1; also elsewhere on the board
GND: J23.3; also elsewhere on the board
GROW_LIGHT_PWM: J23.2; also elsewhere on the board

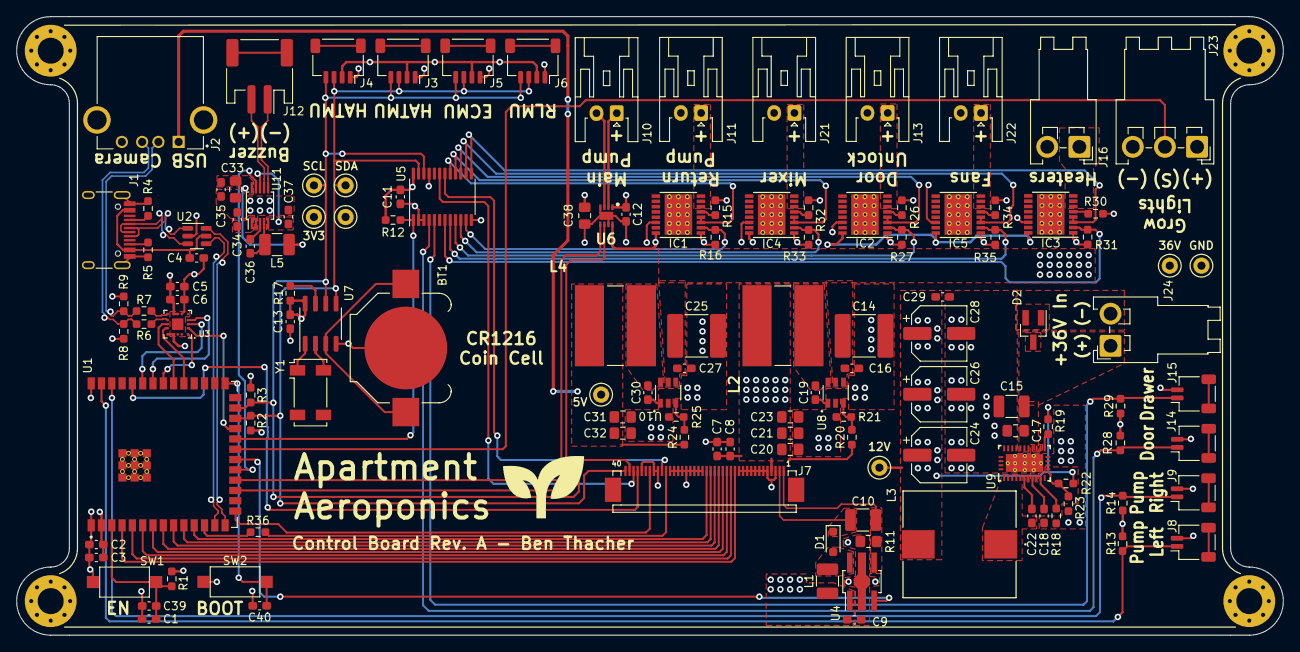
[picture p29: board growth_module_pcb.kicad_pcb from above]

Board: 4 copper layers, 156.2 x 76.2 mm, 130 parts (0 on the bottom side), 97 nets.
